mahmudsamiunlu/Design-and-Implementation-of-a-Fluid-Gauge/README.md

# Design-and-Implementation-of-a-Fluid-Gauge
More Information at ANALOG_Capacitor_Fluid_Level.pdf
