mahmudsamiunlu/Design-and-Implementation-of-a-Fluid-Gauge/(list of files, drawings)

Other design files:
Multisim/ee226_project.ms14
